vpodlesnyi/Gastroscopy-Controller/DOCUMENTATION/51yf0f-YfbL.jpg

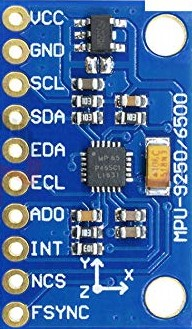
DOCUMENTATION/51yf0f-YfbL.jpg
