vpodlesnyi/Gastroscopy-Controller/DOCUMENTATION/Фотодинамика - Схема соединений.jpg

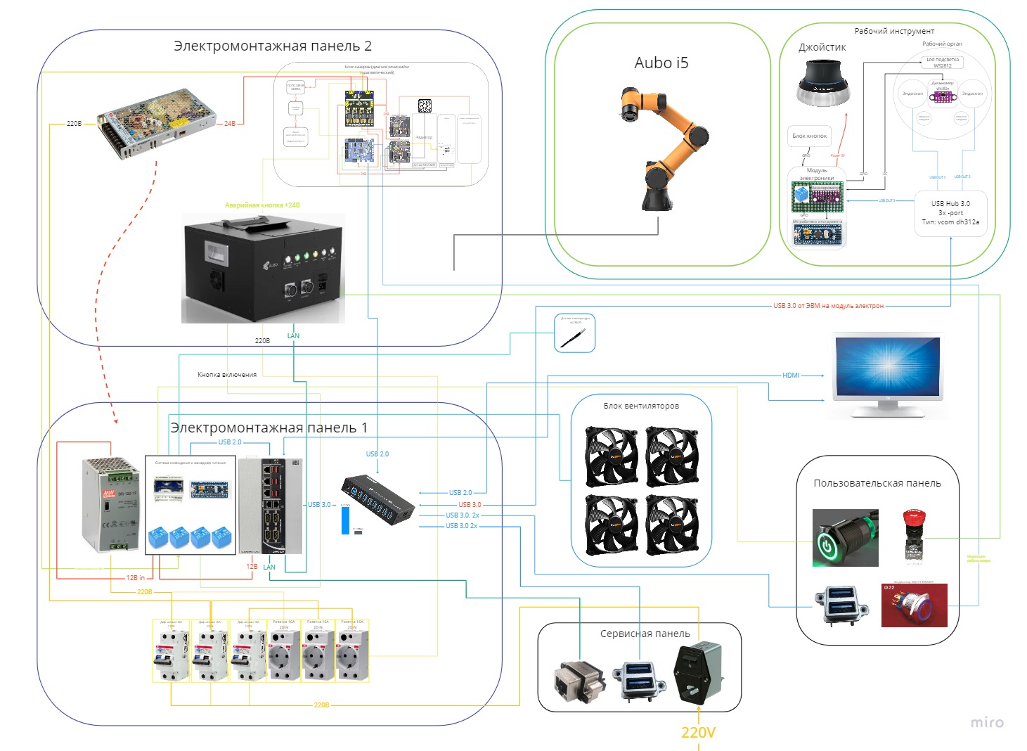
DOCUMENTATION/Фотодинамика - Схема соединений.jpg
