vpodlesnyi/Gastroscopy-Controller/DOCUMENTATION/Рабочий инструмент_ТЗ.docx

Электроника блока рабочего инструмента состоит из двух плат.

1. Плата обработки кнопок и безопасности
  a. Подключение до 6 дискретных кнопок
  b. Подключение акселерометра LIS3DSH (можно прям покупной модуль установить)
  c. Реле 2 штуки
  d. МК stm32f103
  e. Связь через USB
  f. Дополнительный usb type A (мама) для подключения питания джойстика (только питание)
2. Плата трубки
  a. Дальномер vl53l1x (не модуль, сам чип)
  b. Светодиодная подсветка с возможностью регулировки
  c. МК (целесообразность нужно обсудить)

Габариты плат есть в моделях.
