vpodlesnyi/Gastroscopy-Controller/DOCUMENTATION/DS1066-2-FCW.jpg

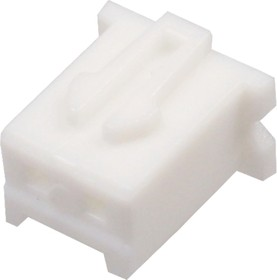
DOCUMENTATION/DS1066-2-FCW.jpg
