vpodlesnyi/Gastroscopy-Controller/DOCUMENTATION/DS1066-6-FCW.jpeg

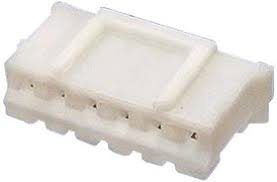
DOCUMENTATION/DS1066-6-FCW.jpeg
