vpodlesnyi/Gastroscopy-Controller/DOCUMENTATION/photo_2022-09-14_12-41-51.jpg

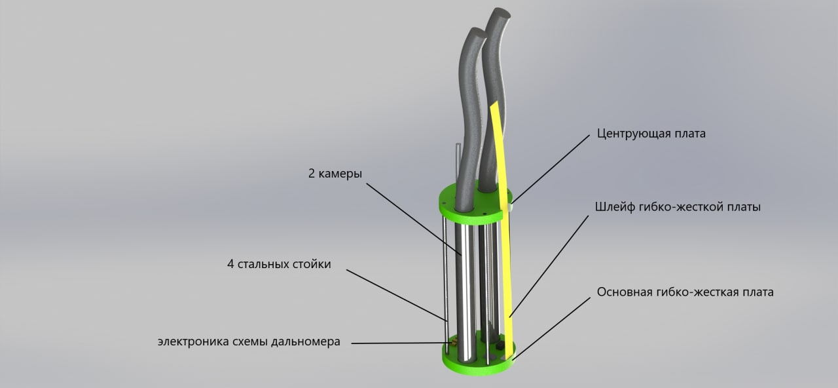
DOCUMENTATION/photo_2022-09-14_12-41-51.jpg
