vpodlesnyi/Gastroscopy-Controller/DOCUMENTATION/photo_2022-09-14_12-46-19.jpg

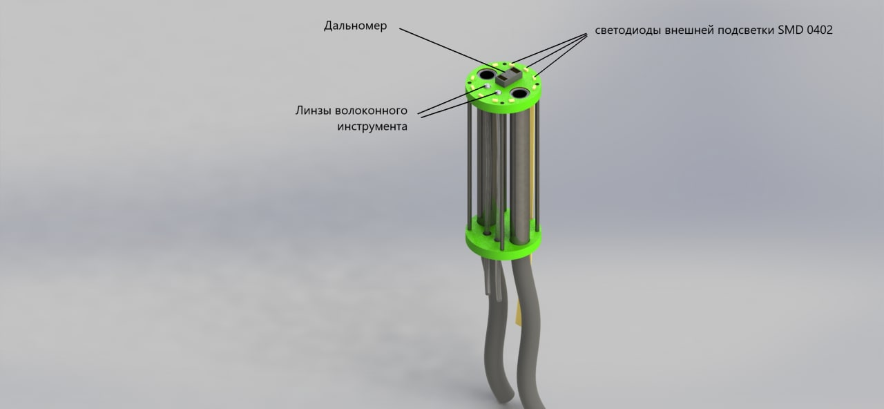
DOCUMENTATION/photo_2022-09-14_12-46-19.jpg
