vpodlesnyi/Gastroscopy-Controller/DOCUMENTATION/photo_2022-10-16_23-45-35.jpg

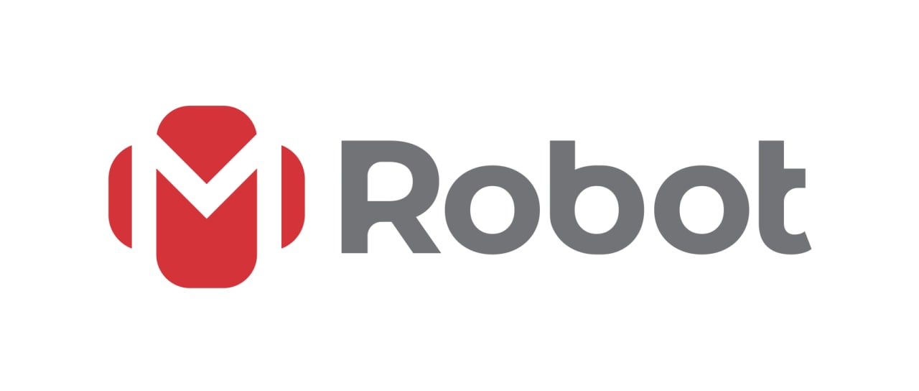
DOCUMENTATION/photo_2022-10-16_23-45-35.jpg
