vpodlesnyi/Gastroscopy-Controller/DOCUMENTATION/photo_2022-10-17_15-40-24-removebg-preview.png

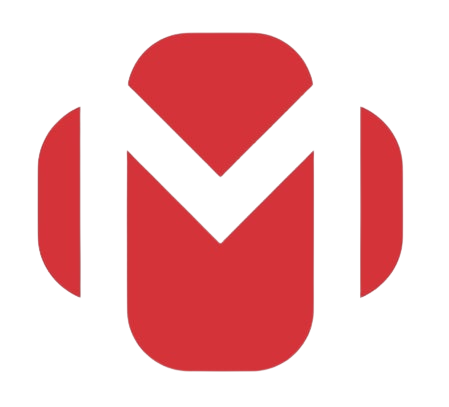
DOCUMENTATION/photo_2022-10-17_15-40-24-removebg-preview.png
