vpodlesnyi/Gastroscopy-Controller/DOCUMENTATION/Безымянный.png

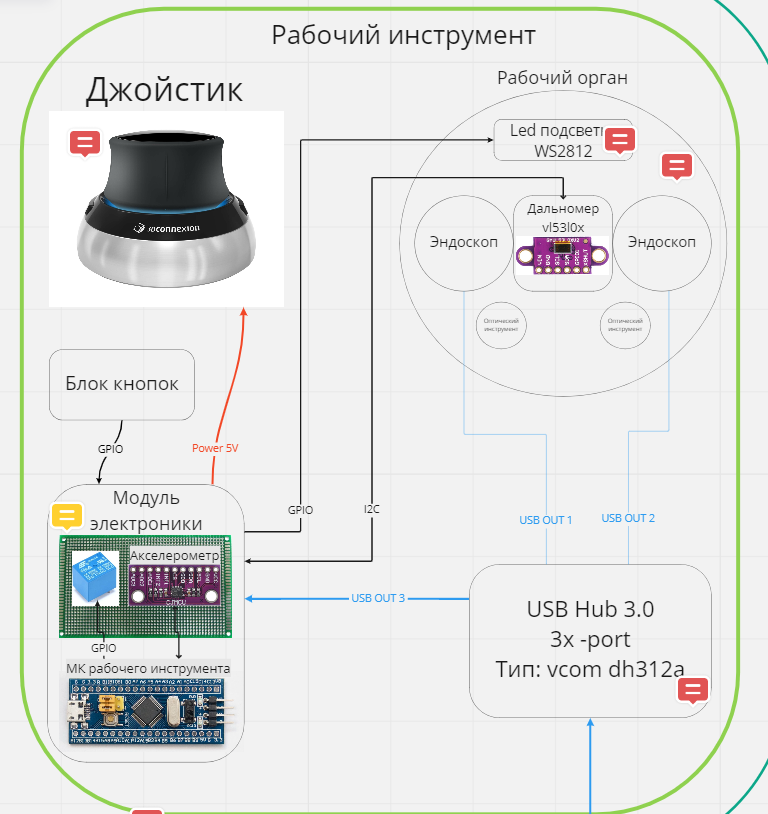
DOCUMENTATION/Безымянный.png
