vpodlesnyi/Gastroscopy-Controller/OUTPUT/BOM/Gastroscopy-Controller_BOM_Rev_0.1.0_No Variations.xlsx

Sheet: Part List Report
Component list
Source Data From: |  | Gastroscopy-Controller.BomDoc
Project: |  | Gastroscopy-Controller.PrjPcb
Variant: |  | None
BOM Revision |  | 0.1.0
Report Date: |  | 11.11.2022 | 12:59
Print Date: |  | 2022-11-16 | 14:18:09
# | Designator | Description | Manufacturer 1 | Manufacturer Part Number 1 | Quantity
1 | C1, C2, C3, C4, C5, C6, C7, C8, C9, C10, C11, C12, C15, C17, C18, C19, C20, C24, C25, C27, C28 | CAP CER 0.1UF 50V X7R 0603 | Samsung | CL10B104KB8NNNL | 21
2 | C13, C14, C16, C23, C26 | CAP CER 10UF 16V X7R 0805 | Samsung | CL21B106KOQNNNE | 5
3 | C21, C22 | CAP CER 30PF 50V NPO 0603 | Yageo | CC0603JRNPO9BN300 | 2
4 | D1, D2, D3, D4, D5, D6, D14, D15 | TVS DIODE 5VWM 9.2VC SMB | Good-Ark | SMBJ5.0CA | 8
5 | D7, D10, D12 | DIODE SCHOTTKY 40V 1A SOD323 | Nexperia | PMEG4010BEA115 | 3
6 | D8 | LED BLUE CLEAR CHIP SMD | Vishay Lite-On | LTST-C193TBKT-5A | 1
7 | D9 | LED GREEN CLEAR SMD | Vishay Lite-On | LTST-C191KGKT | 1
8 | D11, D13 | TVS DIODE 24VWM 38.9VC SMB | Taiwan Semiconductor | SMBJ24A | 2
9 | DA1, DA2, DA3, DA4, DA5, DA6 | OPTOISOLATOR 5KV TRANSISTOR 4SMD | Broadcom Avago | HCPL-817-50CE | 6
10 | DA7 | IC REG LINEAR 3.3V 500MA SOT23-5 | Texas Instruments | TLV75533PDBVR | 1
11 | HW1, HW4, HW7, HW10, HW13, HW16 | CONN SOCKET 2POS 2MM | Connfly electronic (Zhenqin) | DS1066-2-FCW | 6
12 | HW2, HW3, HW5, HW6, HW8, HW9, HW11, HW12, HW14, HW15, HW17, HW18, HW19, HW20, HW22, HW23, HW25, HW26, HW27, HW28, HW29, HW30, HW31, HW32 | СONNECTOR DS1066 | Connfly electronic (Zhenqin) | T-DS1066-SC600-N-019 | 24
13 | HW21, HW24 | CONN SOCKET 6POS 2MM | Connfly electronic (Zhenqin) | DS1066-6-FCW | 2
14 | HW33 | CLOSED TOP JUMPER SOCKET | Harwin | M7686-05 | 1
15 | J1, J2 | TERM BLK 3P TOP ENTRY 5MM SMD | Degson | DG128-5.0-03P-14-00AH | 2
16 | J3 | CONN RCPT USB2.0 TYPEA 4POS R/A | TE Connectivity | 292303-1 | 1
17 | J4 | CONN TYPE B SKT HORIZONTAL TH | Ningbo Connfly Electric | DS1099-WN0 | 1
18 | JP1, JP2, JP3, JP4, JP5, JP6 | CONN HEADER 2POS 2MM | Connfly electronic (Zhenqin) | DS1066-2MVW6X | 6
19 | JP7, JP8 | CONN PLUG 6POS 2MM | Connfly electronic (Zhenqin) | DS1066-6MVW6X | 2
20 | JP9 | CONN HEADER VERT 6POS 2.54MM | Wurth Electronics | 61300611121 | 1
21 | JP10 | CONN HEADER VERT 2POS 2.54MM | Wurth Electronics | 61300211121 | 1
22 | K1, K2 | RELAY GEN PURPOSE SPDT 10A 5V | TE Connectivity Schrack | RT174005 | 2
23 | L1 | FIXED IND 4.7UH 650MA 270MOHM SM | TDK | NLC453232T-4R7K-PF | 1
24 | Q1, Q2 | MOSFET N-CH 30V 3.3A/3.6A SOT23 | Vishay Siliconix | SI2304DDS-T1-GE3 | 2
25 | R1, R4, R7, R10, R13, R16, R25 | RES 360 OHM 1% 1/10W 0603 | Yageo | RC0603FR-07360RL | 7
26 | R2, R5, R8, R11, R14, R17 | RES 1K OHM 1% 1/10W 0603 | Yageo | RC0603FR-071KL | 6
27 | R3, R6, R9, R12, R15, R18, R24, R27, R29 | RES 100 OHM 1% 1/10W 0603 | Yageo | RC0603FR-07100RL | 9
28 | R19, R22, R23, R26, R28, R30, R34 | RES 10K OHM 1% 1/10W 0603 | Yageo | RC0603FR-0710KL | 7
29 | R20 | RES 62K OHM 1% 1/10W 0603 | Yageo | RC0603FR-0762KL | 1
30 | R21 | RES 10 OHM 1% 1/10W 0603 | Yageo | RC0603FR-0710RL | 1
31 | R31, R32 | RES 24 OHM 1% 1/10W 0603 | Yageo | RC0603FR-0724RL | 2
32 | R33 | RES 1.5K OHM 1% 1/10W 0603 | Yageo | RC0603FR-071K5L | 1
33 | U1 | IC LED DRVR RGLTR PWM 20MA 8QFN | STMicroelectronics | STLD40DPUR | 1
34 | U2 | TVS DIODE 5VWM 17.5VC SOT23-6 | Sangdest Microelectronics | SRV05-4ATR | 1
35 | U3 | IC MCU 32BIT 128KB FLASH 48LQFP | STMicroelectronics | STM32F103CBT6 | 1
36 | U4 | TVS DIODE 5.25VWM 17VC SOT23-6 | STMicroelectronics | USBLC6-2SC6 | 1
37 | U5 | ACCEL 2-16G I2C/SPI 16LGA | STMicroelectronics | LIS3DHTR | 1
38 | Y1 | CRYSTAL 8.0000MHZ 18PF TH | CTS | ATS080B-E | 1
Total |  |  |  |  | 142

Sheet: Project Information
Project Full Path | C:\Users\Naval\OneDrive\Документы\Gastroscopy-Controller\Gastroscopy-Controller.PrjPcb
Project Filename | Gastroscopy-Controller.PrjPcb
Variant Name | None
Data-Source Filename | Gastroscopy-Controller.BomDoc
Data-Source Full Path | C:\Users\Naval\OneDrive\Документы\Gastroscopy-Controller\BOM\Gastroscopy-Controller.BomDoc
Title | BOM for BOM Document [Gastroscopy-Controller.BomDoc]
Total Quantity | 142
Report Time | 12:59
Report Date | 11.11.2022
Report Date & Tine | 11.11.2022 12:59
Output Name | BOM
Output Type | BomReport
Output Generator Name | BOM
Output Generator Description | Bill of Materials
