vpodlesnyi/Gastroscopy-Controller/DOCUMENTATION/плата_15_1.DXF

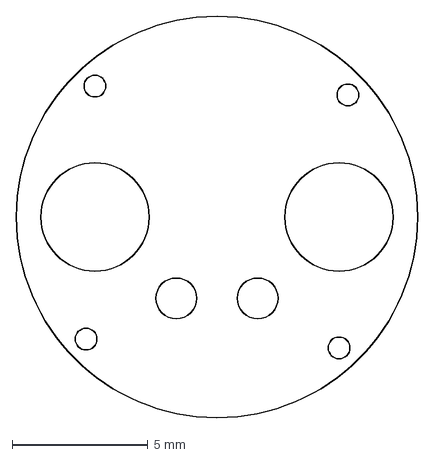
[picture p10: CAD file, 2022-11-09]
DOCUMENTATION/плата_15_1.DXF
14.8 x 14.8 mm
