vpodlesnyi/Gastroscopy-Controller/DOCUMENTATION/плата_130х70.DXF

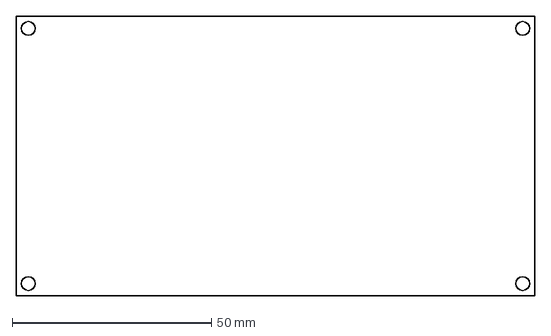
[picture p11: CAD file, 2022-11-09]
DOCUMENTATION/плата_130х70.DXF
130.0 x 70.0 mm
