vpodlesnyi/Gastroscopy-Controller/DOCUMENTATION/плата_15_2.DXF

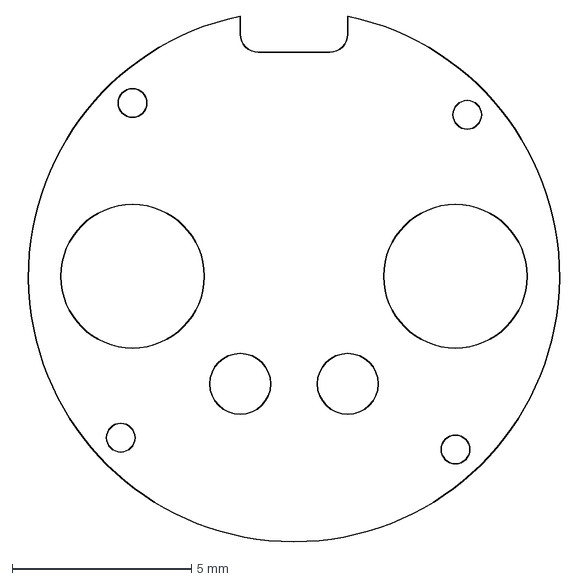
[picture p12: CAD file, 2022-11-09]
DOCUMENTATION/плата_15_2.DXF
15.5 x 14.6 mm
