vpodlesnyi/Gastroscopy-Controller/OUTPUT/SCH/Gastroscopy-Controller_SCH_Rev_0.1.0_[No Variations].PDF

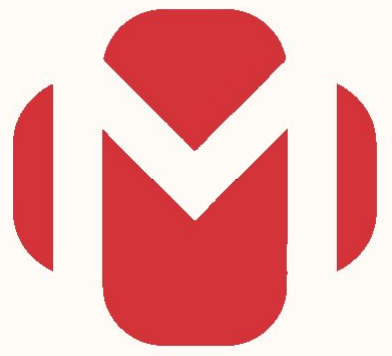
[picture p13: figure]

16.11.2022

# GastroscopyController

### Company: MRobot, LCC

Jira Key: | GSTRCNTRL
Project: | Gastroscopy Controller

# Gastroscopy Controller

Overview
Gastroscopy-Controller_Overview.SchDoc

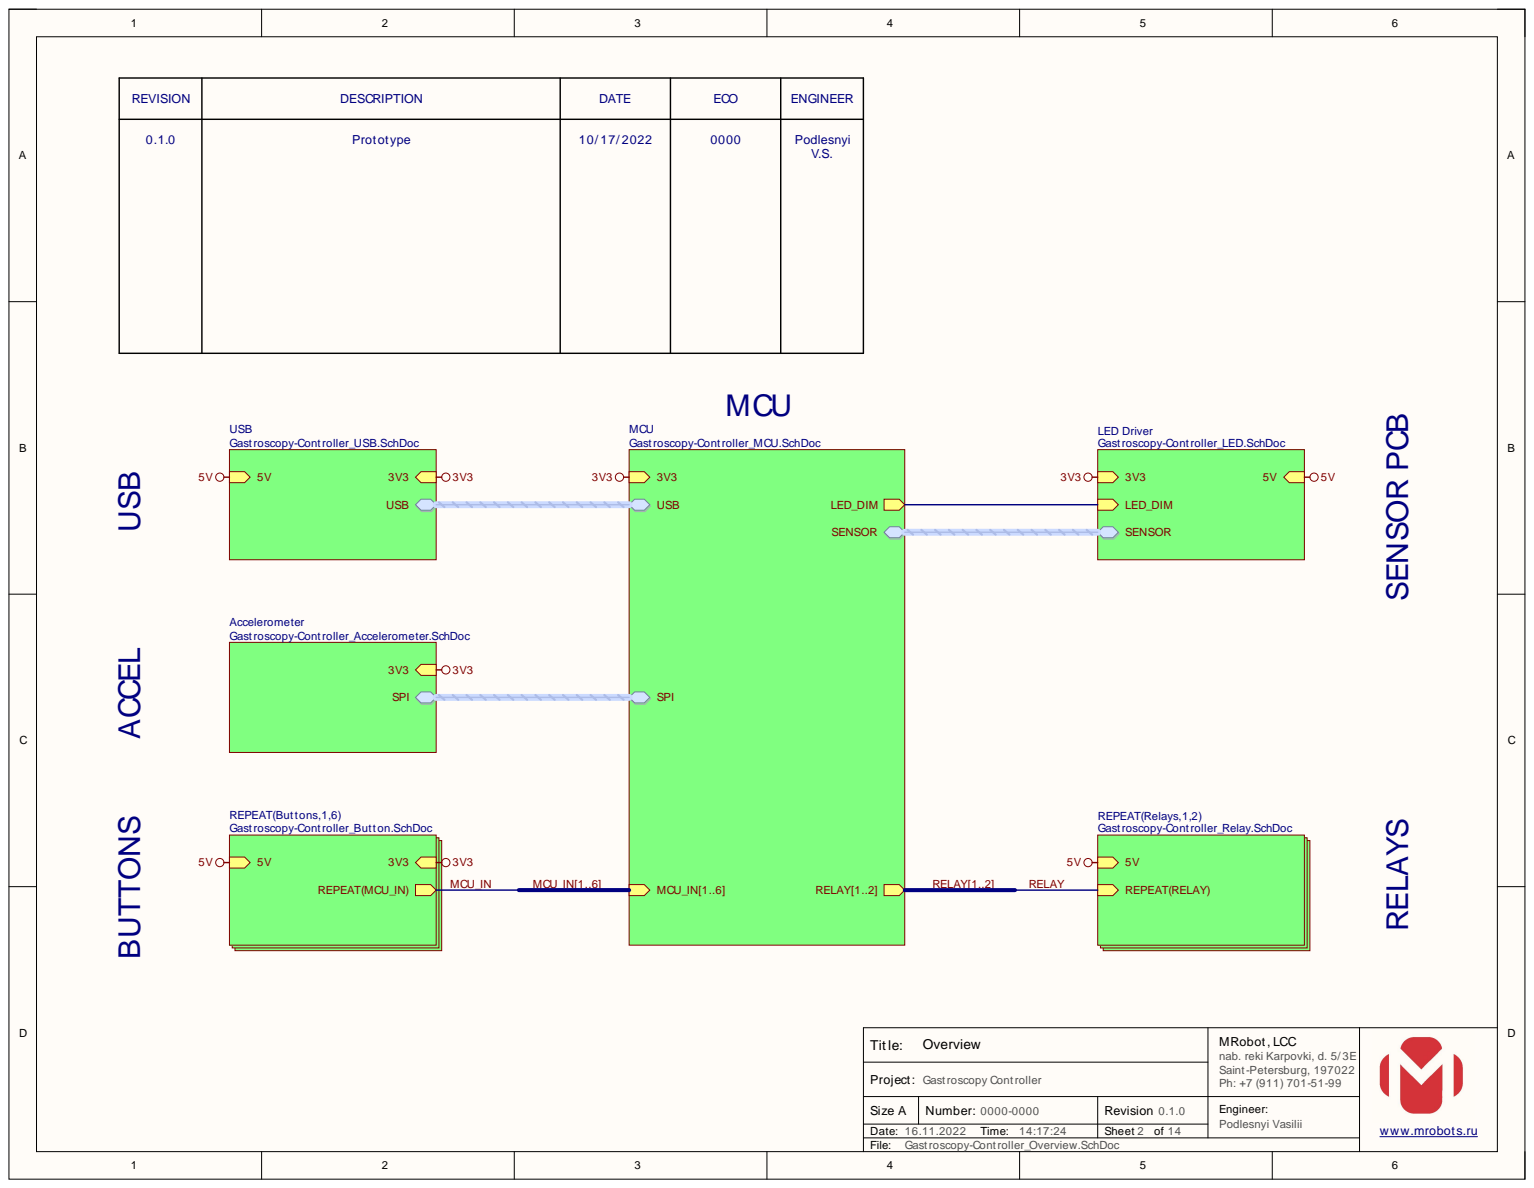
[picture p14: page 2]

REVISION | DESCRIPTION | DATE | ECO | ENGINEER

0.1.0 | Protot ype | 10/ 17/ 2022 | 0000 | Podlesnyi V.S.

Size A | Number: | Revision 0.1.0 | Engineer: Podlesnyi Vasilii

Date: 16.11.2022 Time: 14:17:24 | | Sheet of

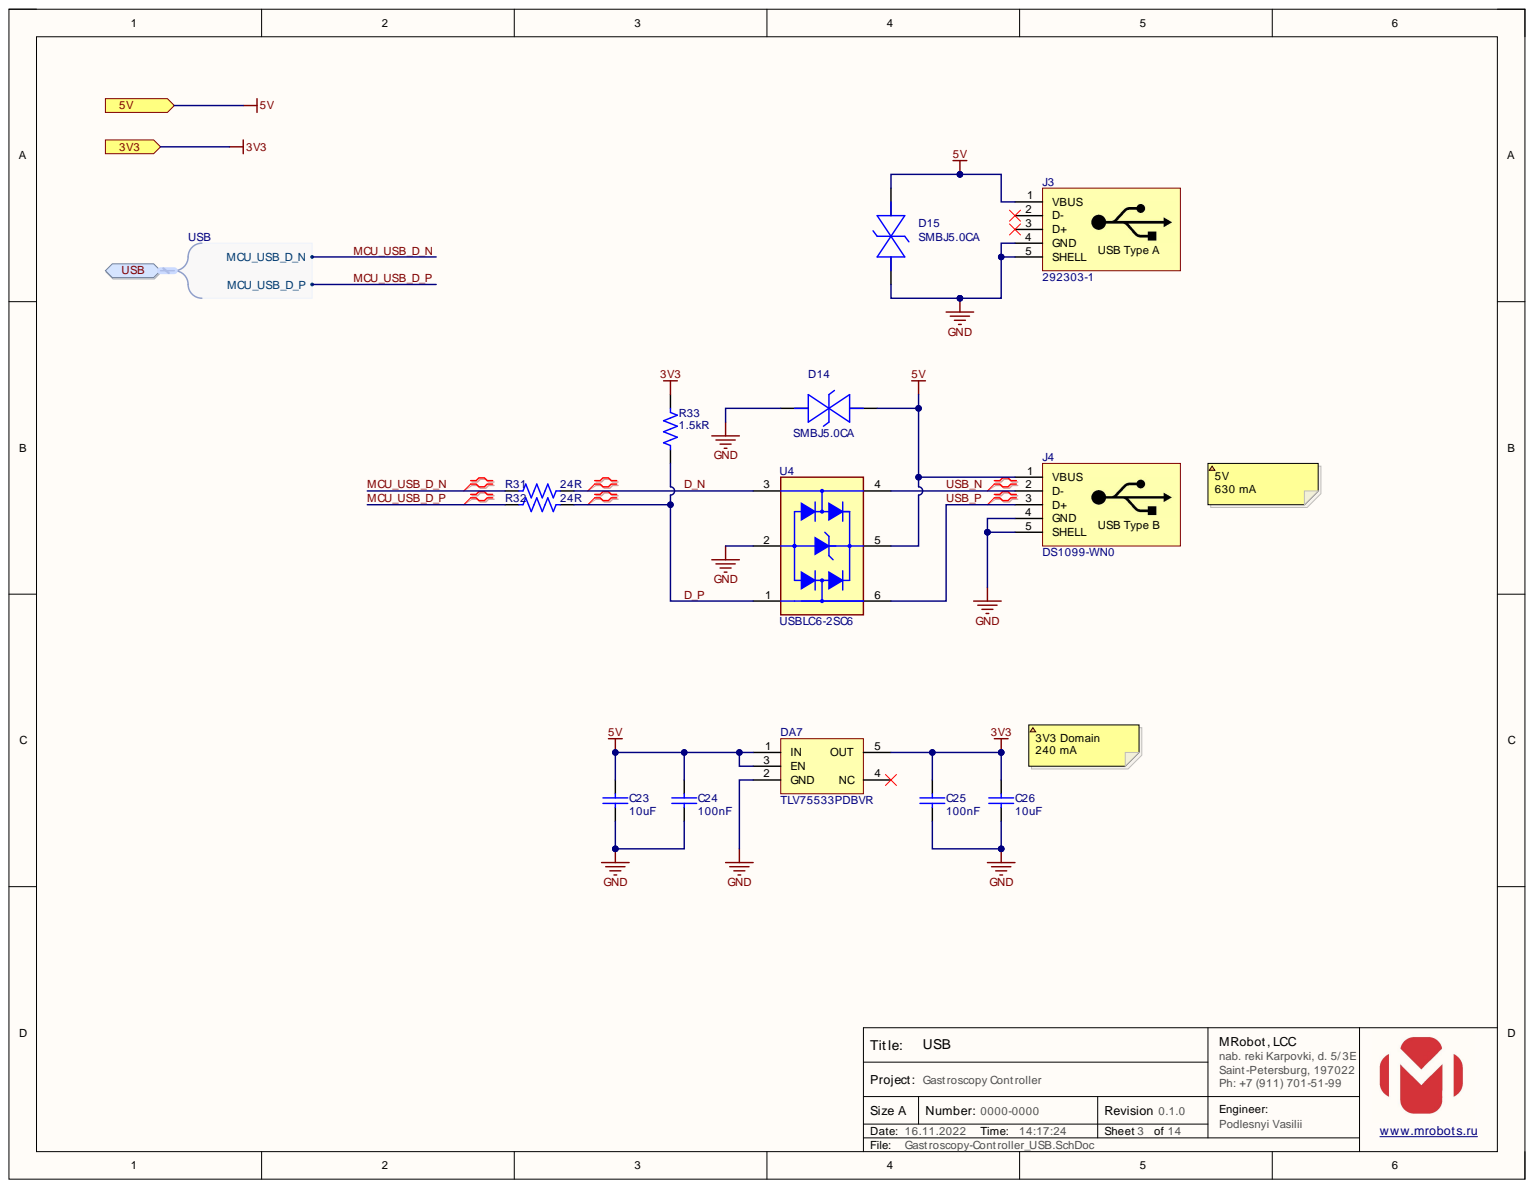
[picture p15: page 3]

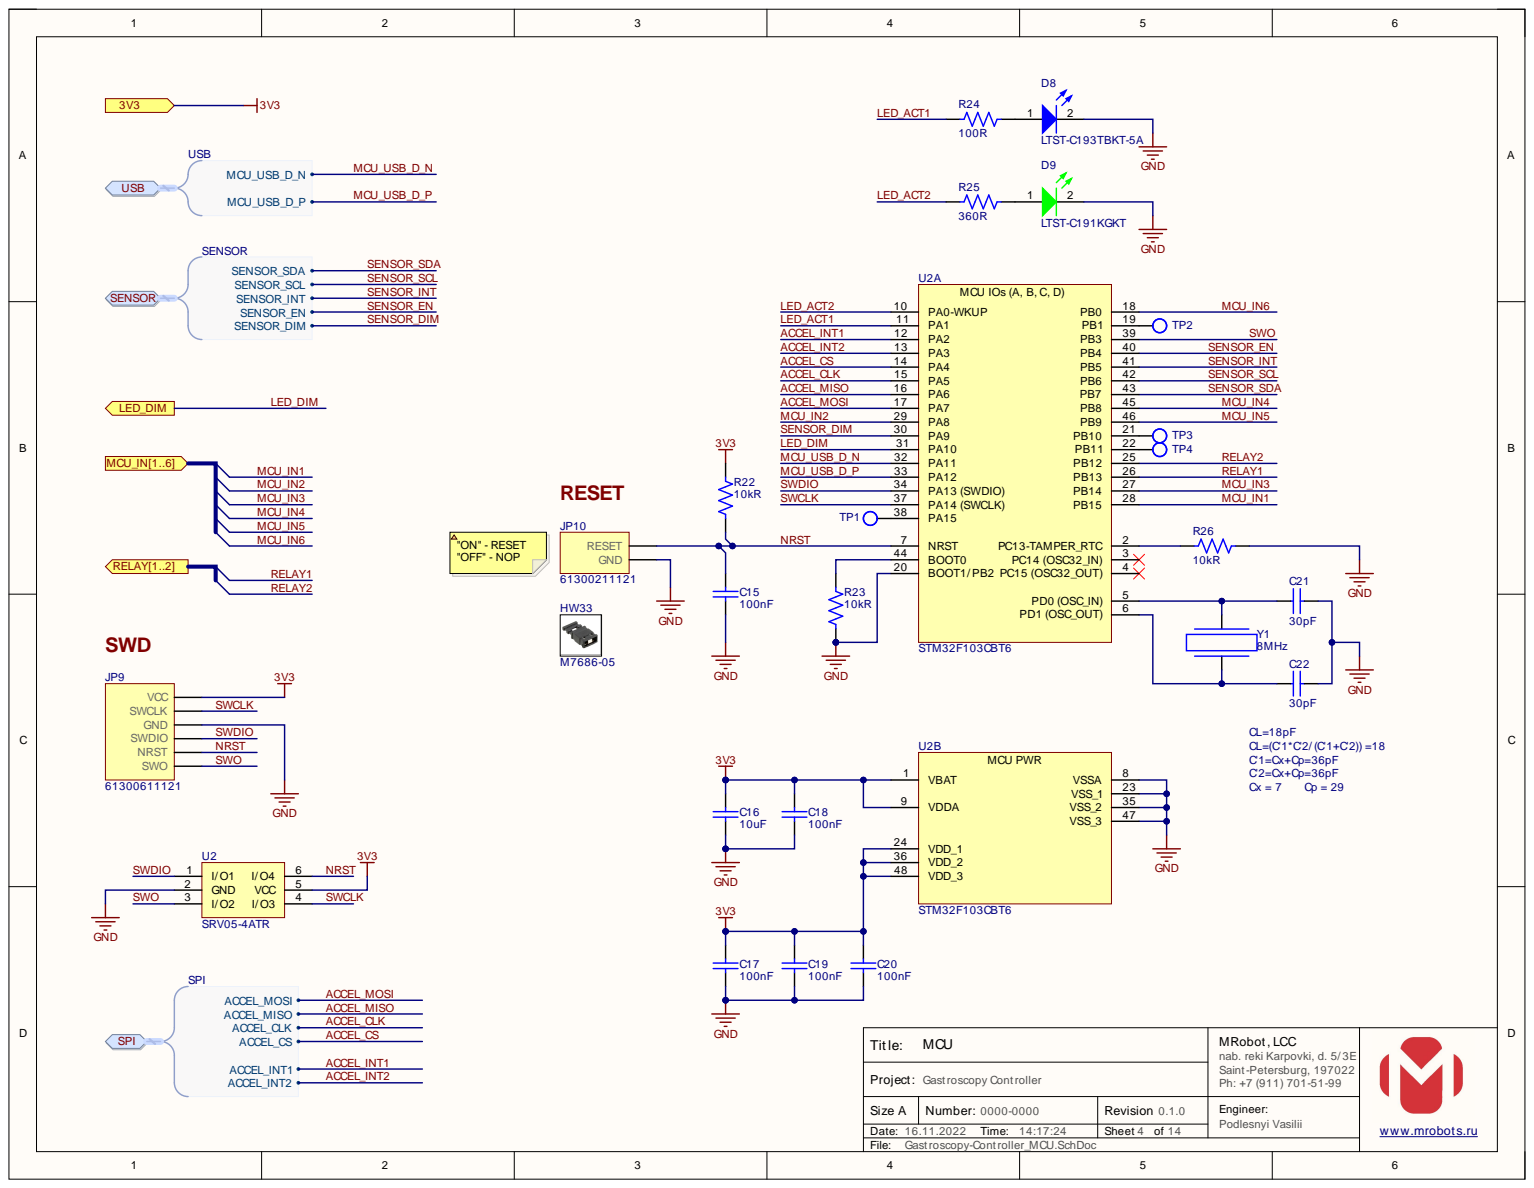
[picture p16: page 4]

BOOT0 44
BOOT1/ PB2 20

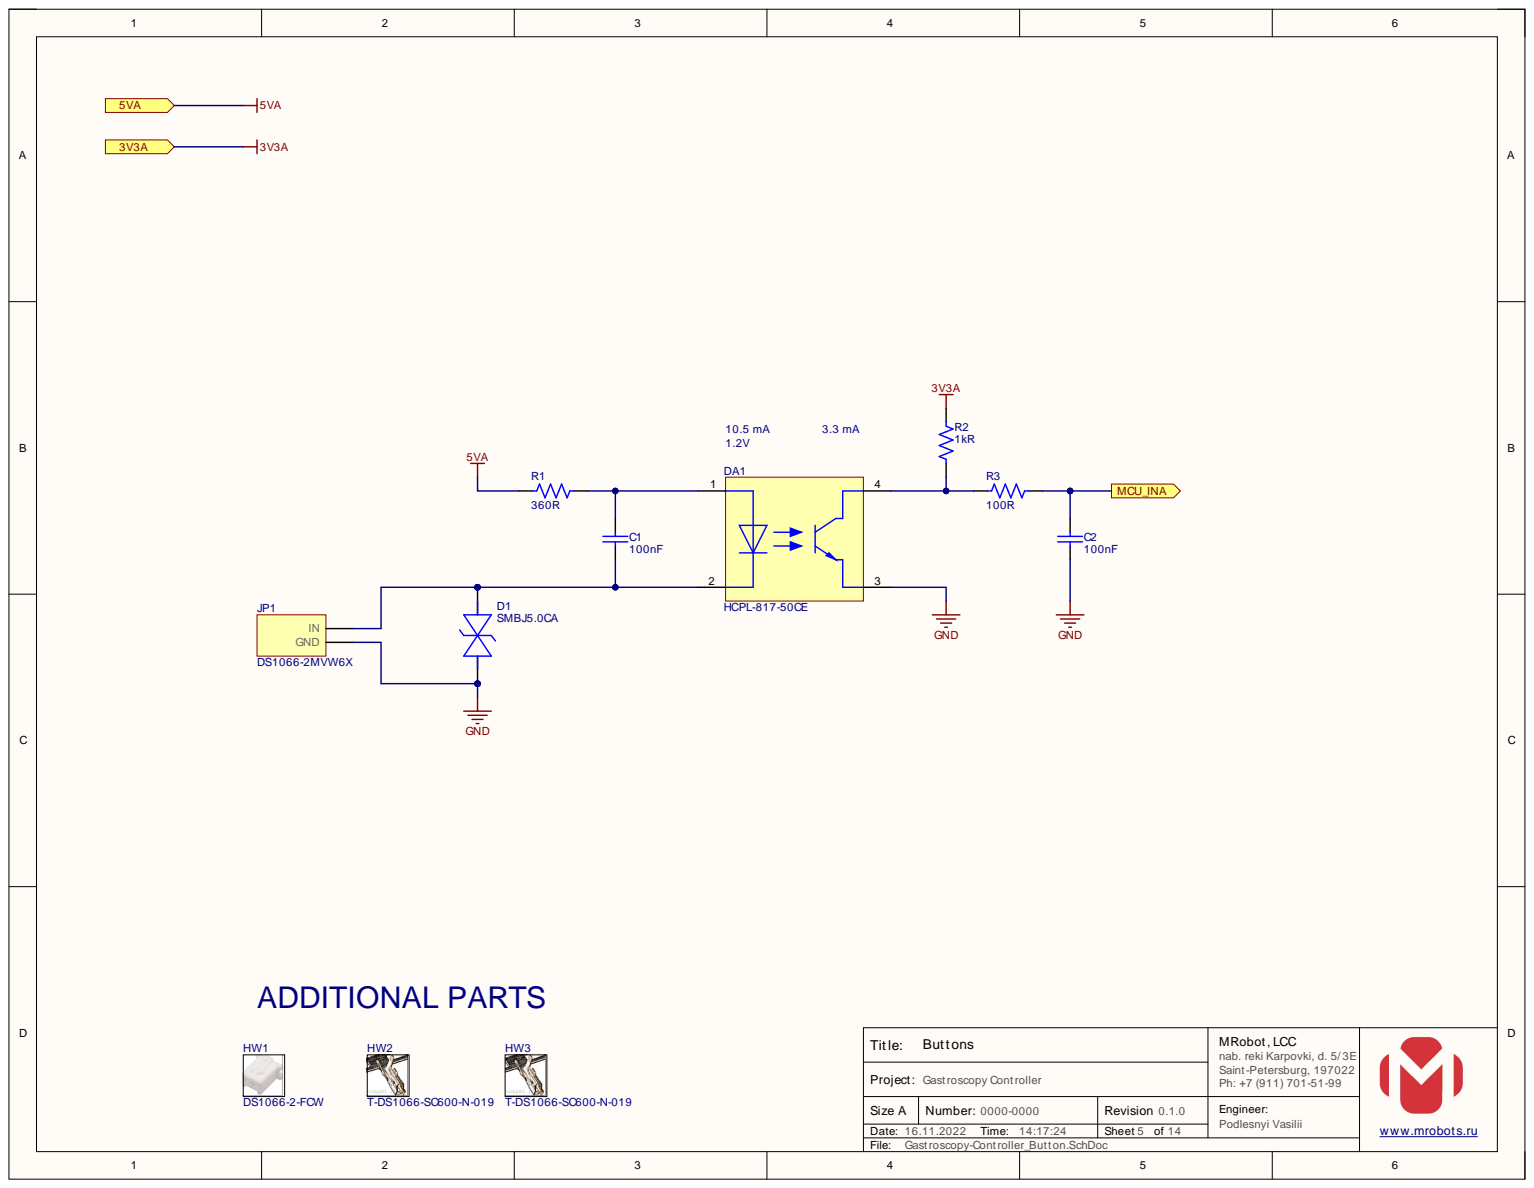
[picture p17: page 5]

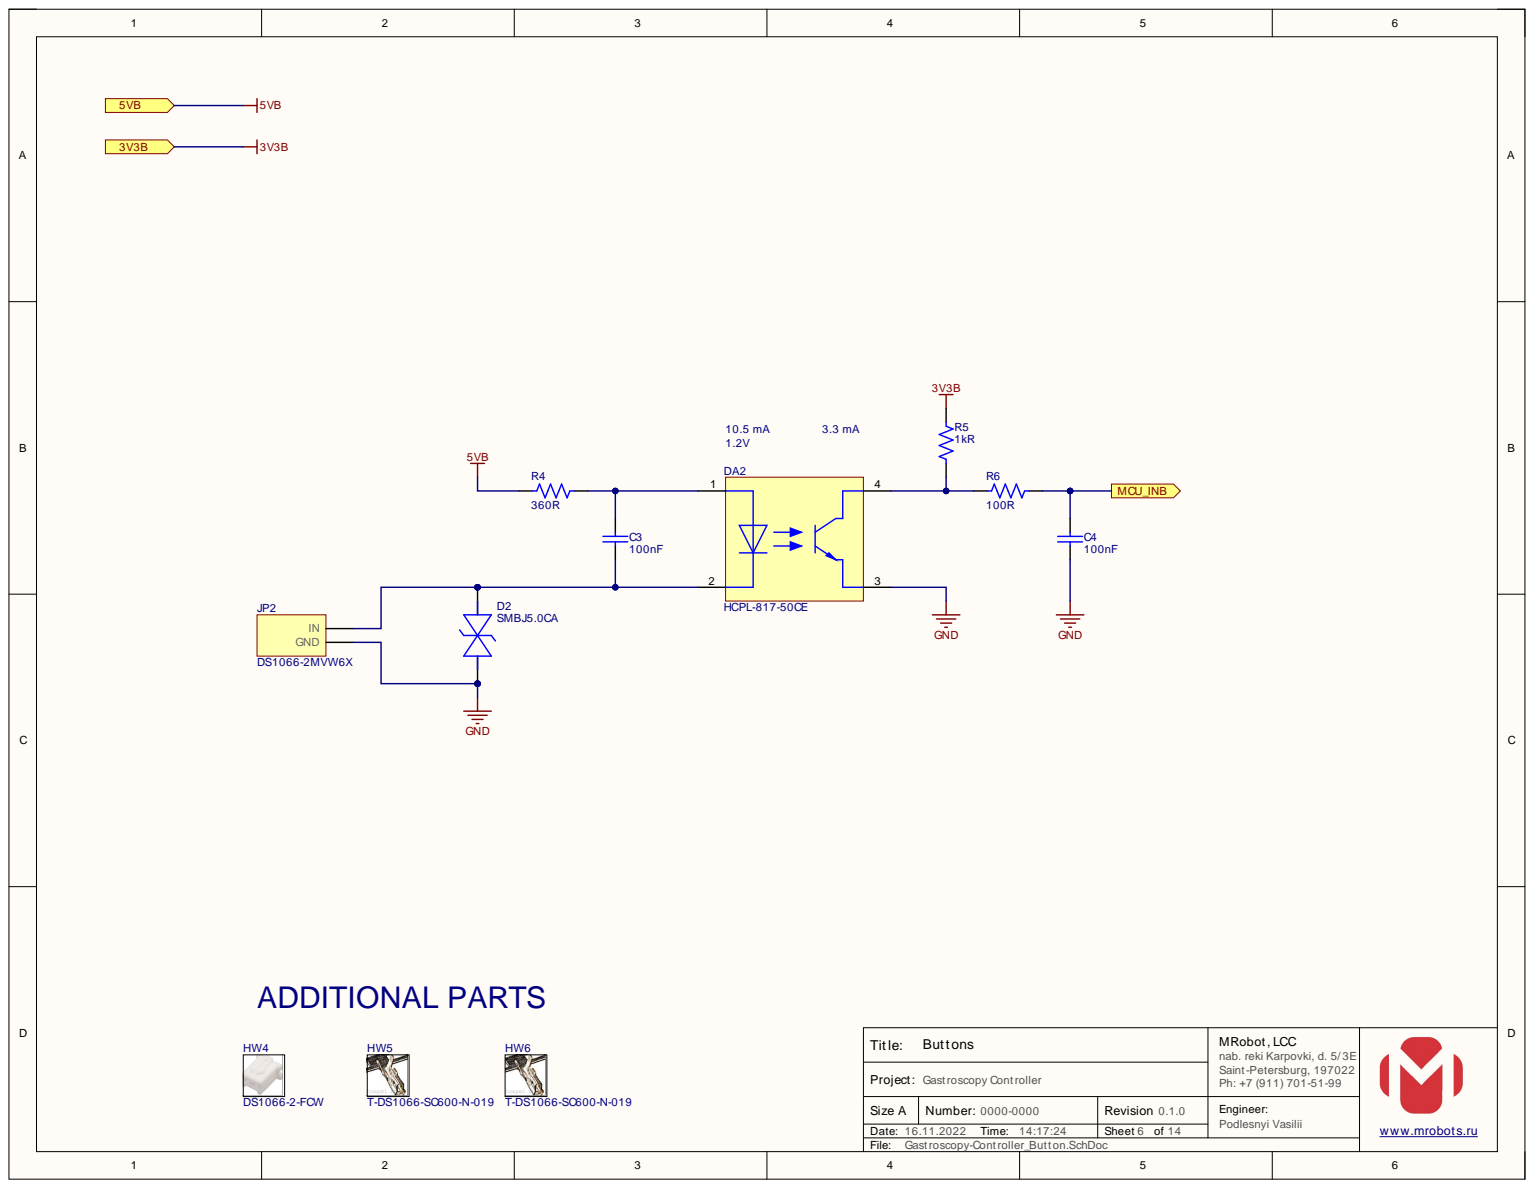
[picture p18: page 6]

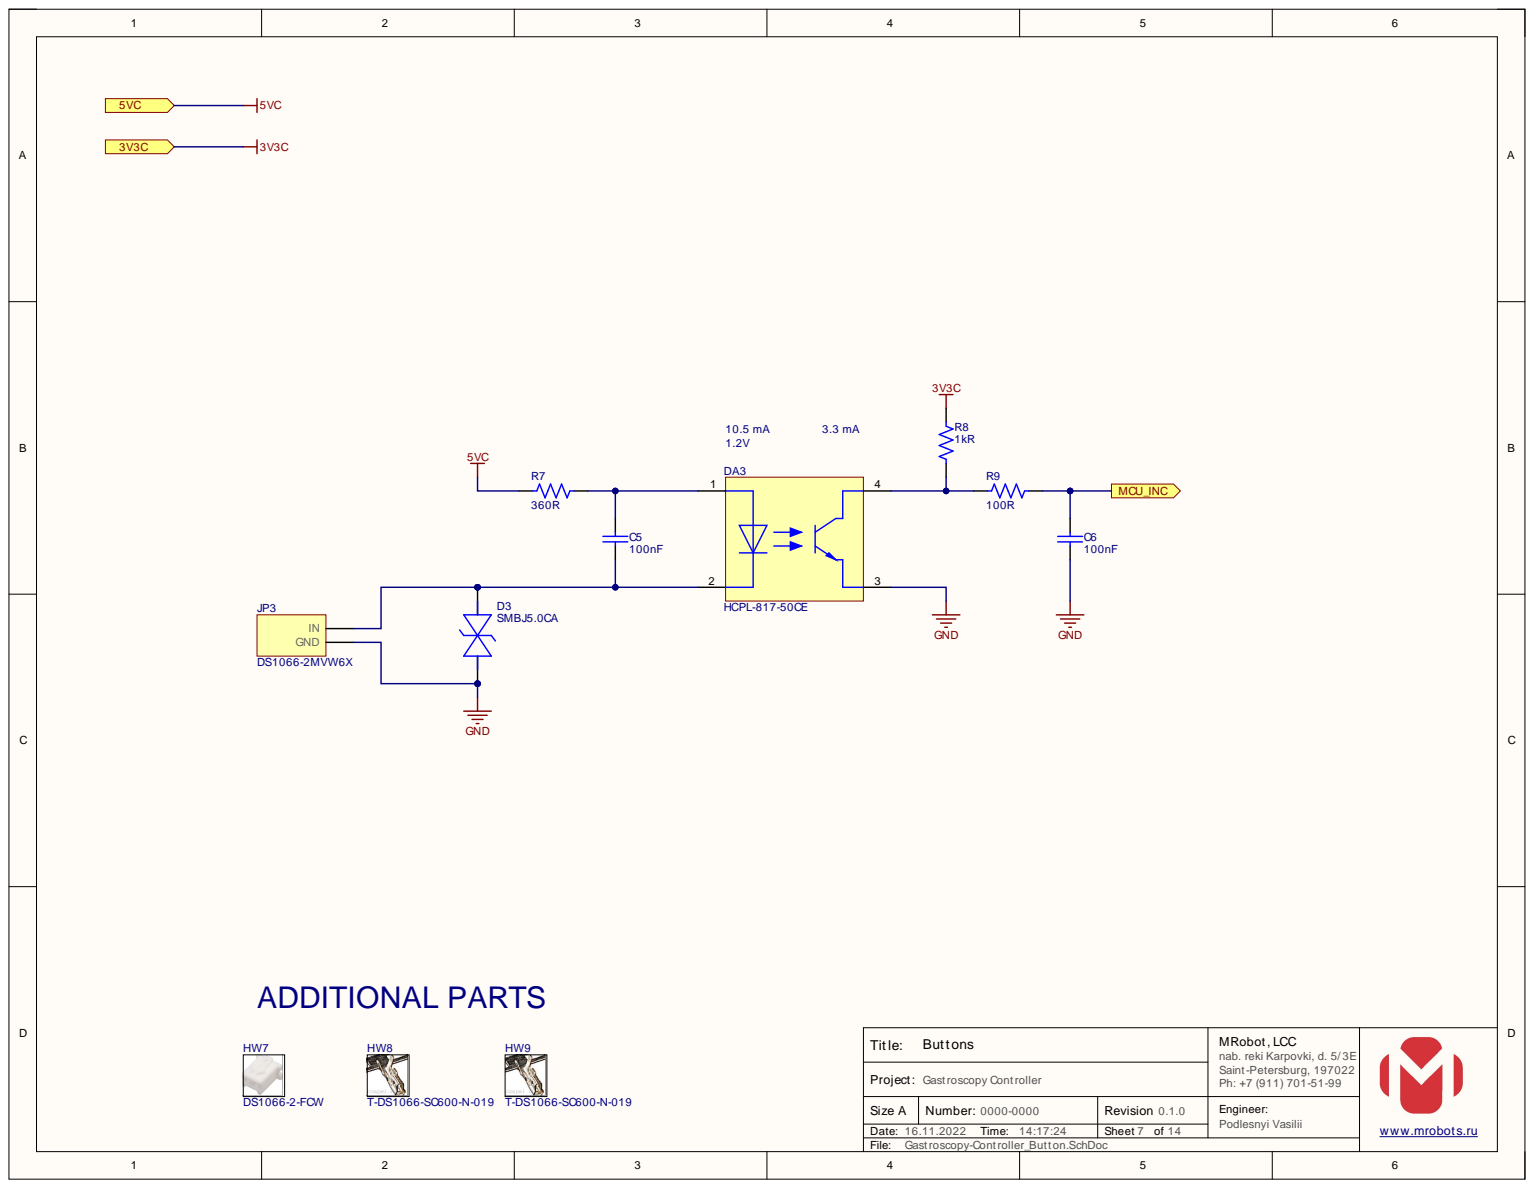
[picture p19: page 7]

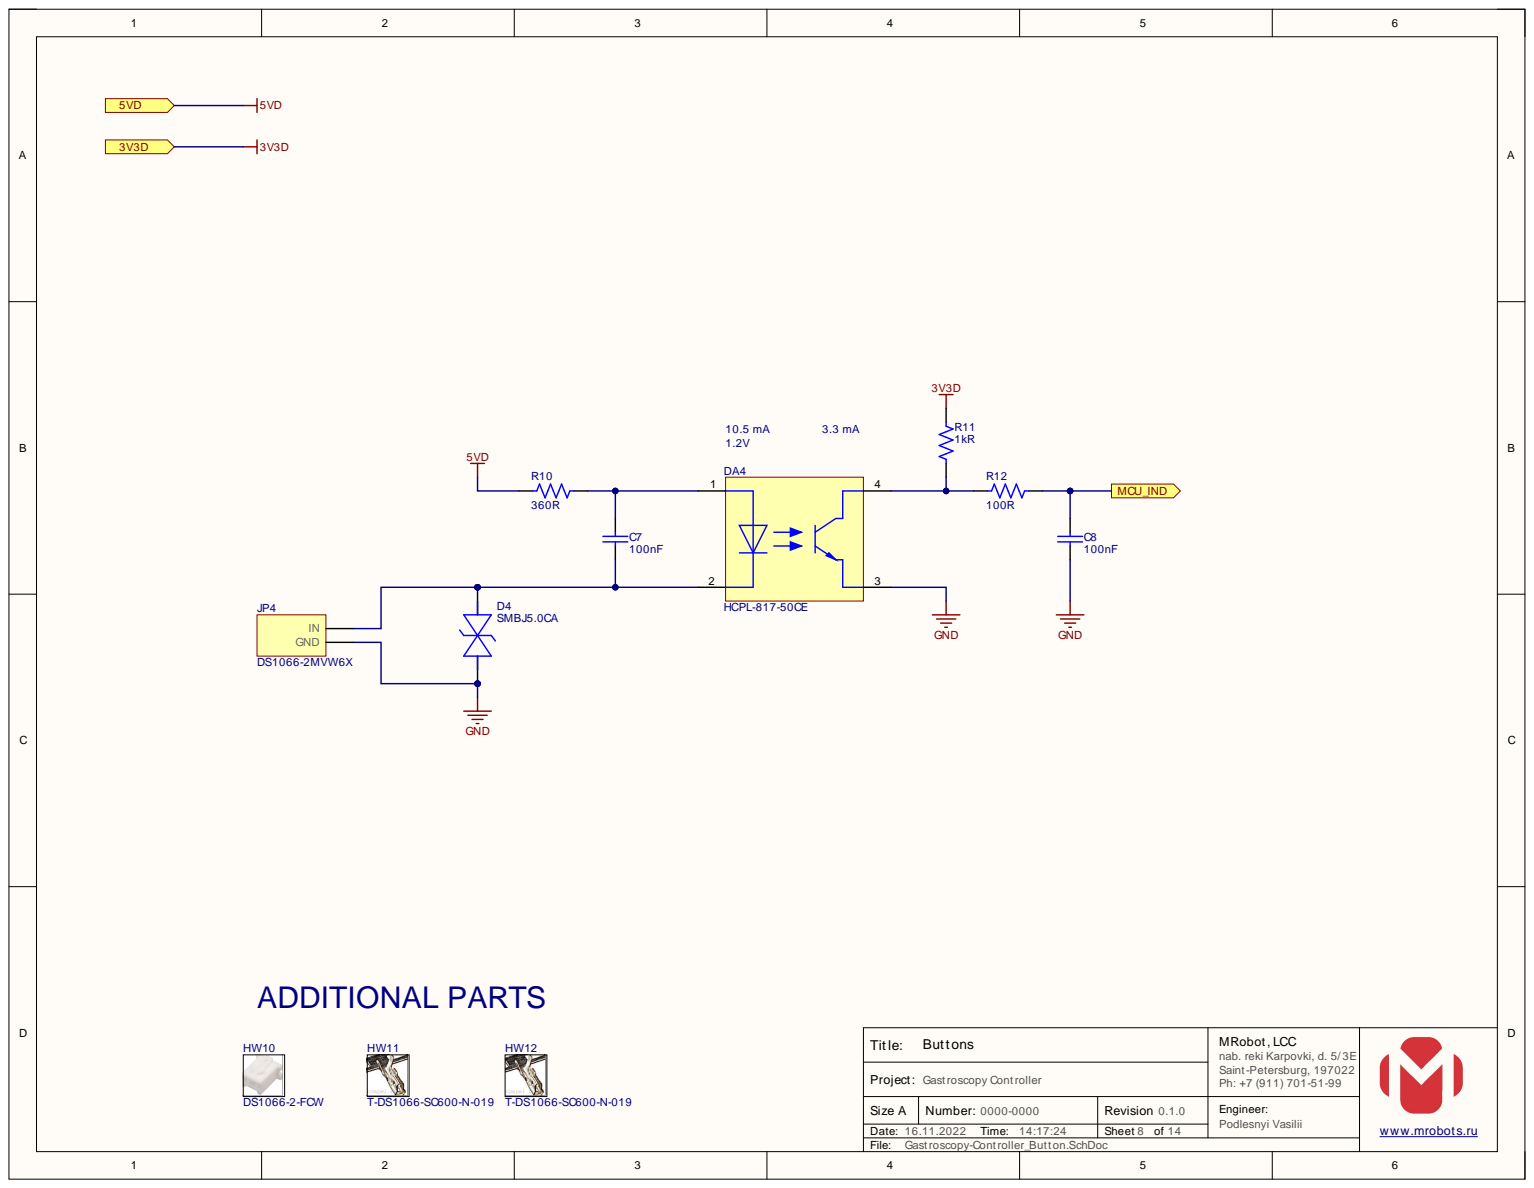
[picture p20: page 8]

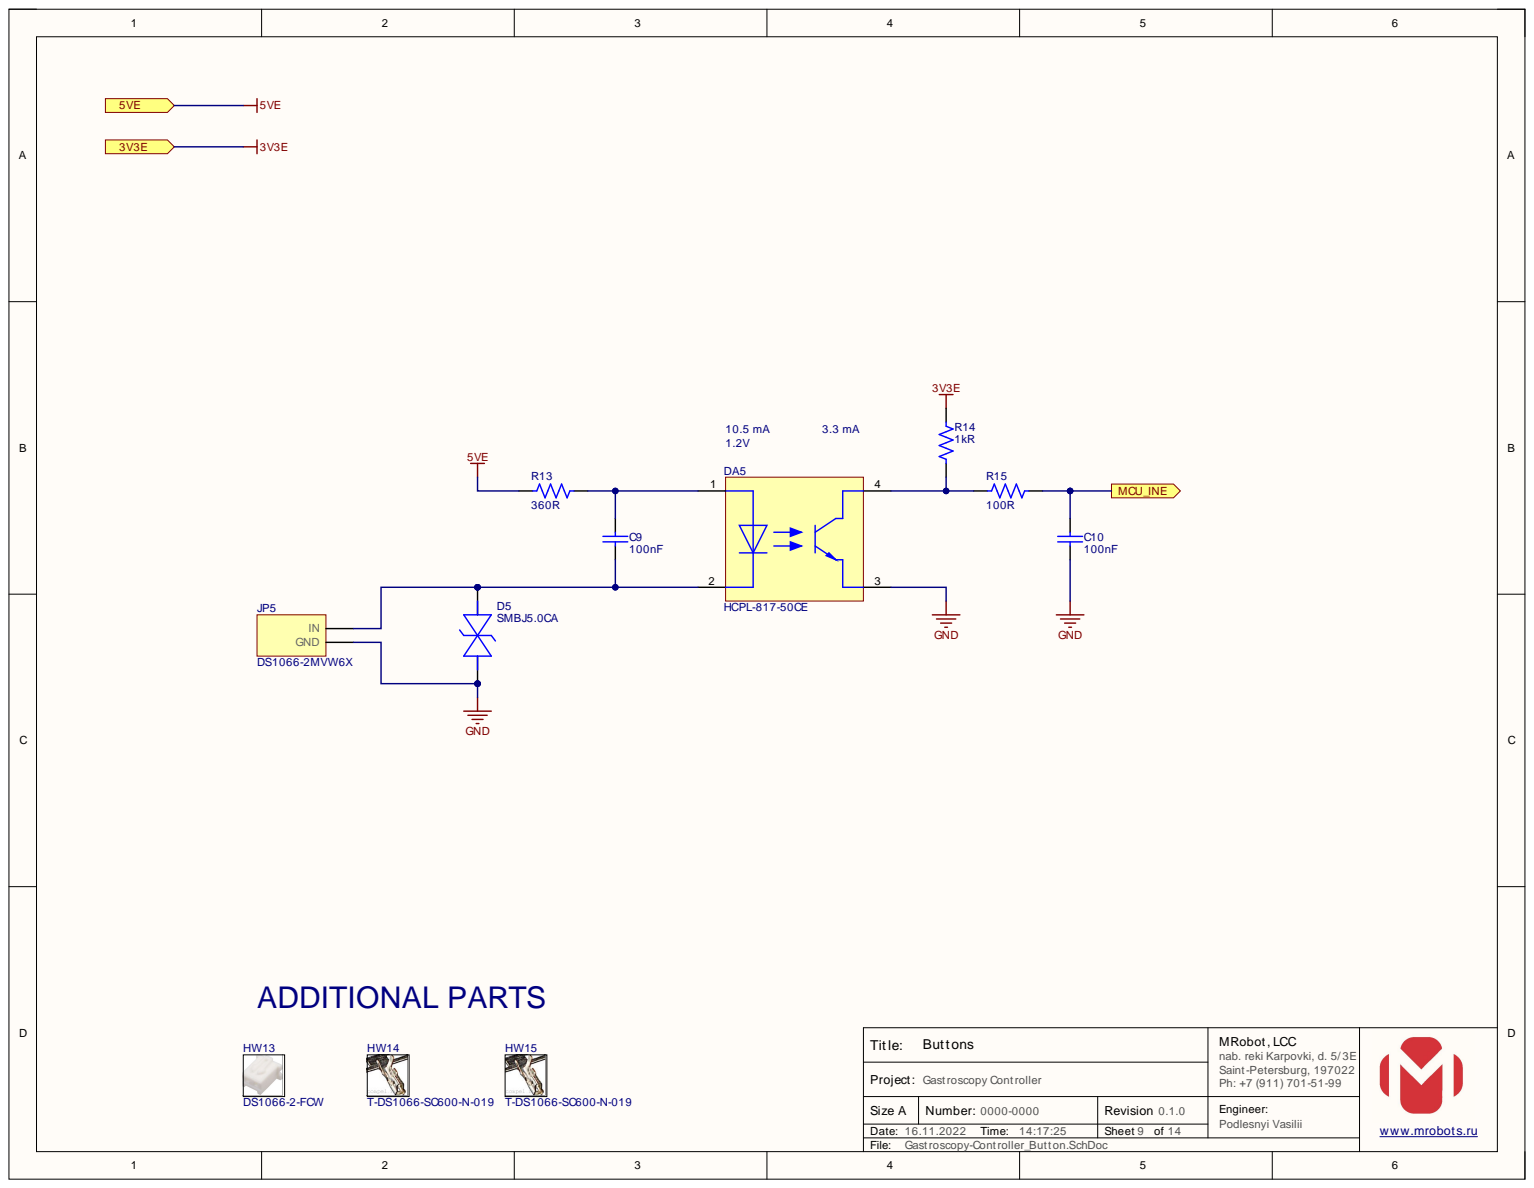
[picture p21: page 9]

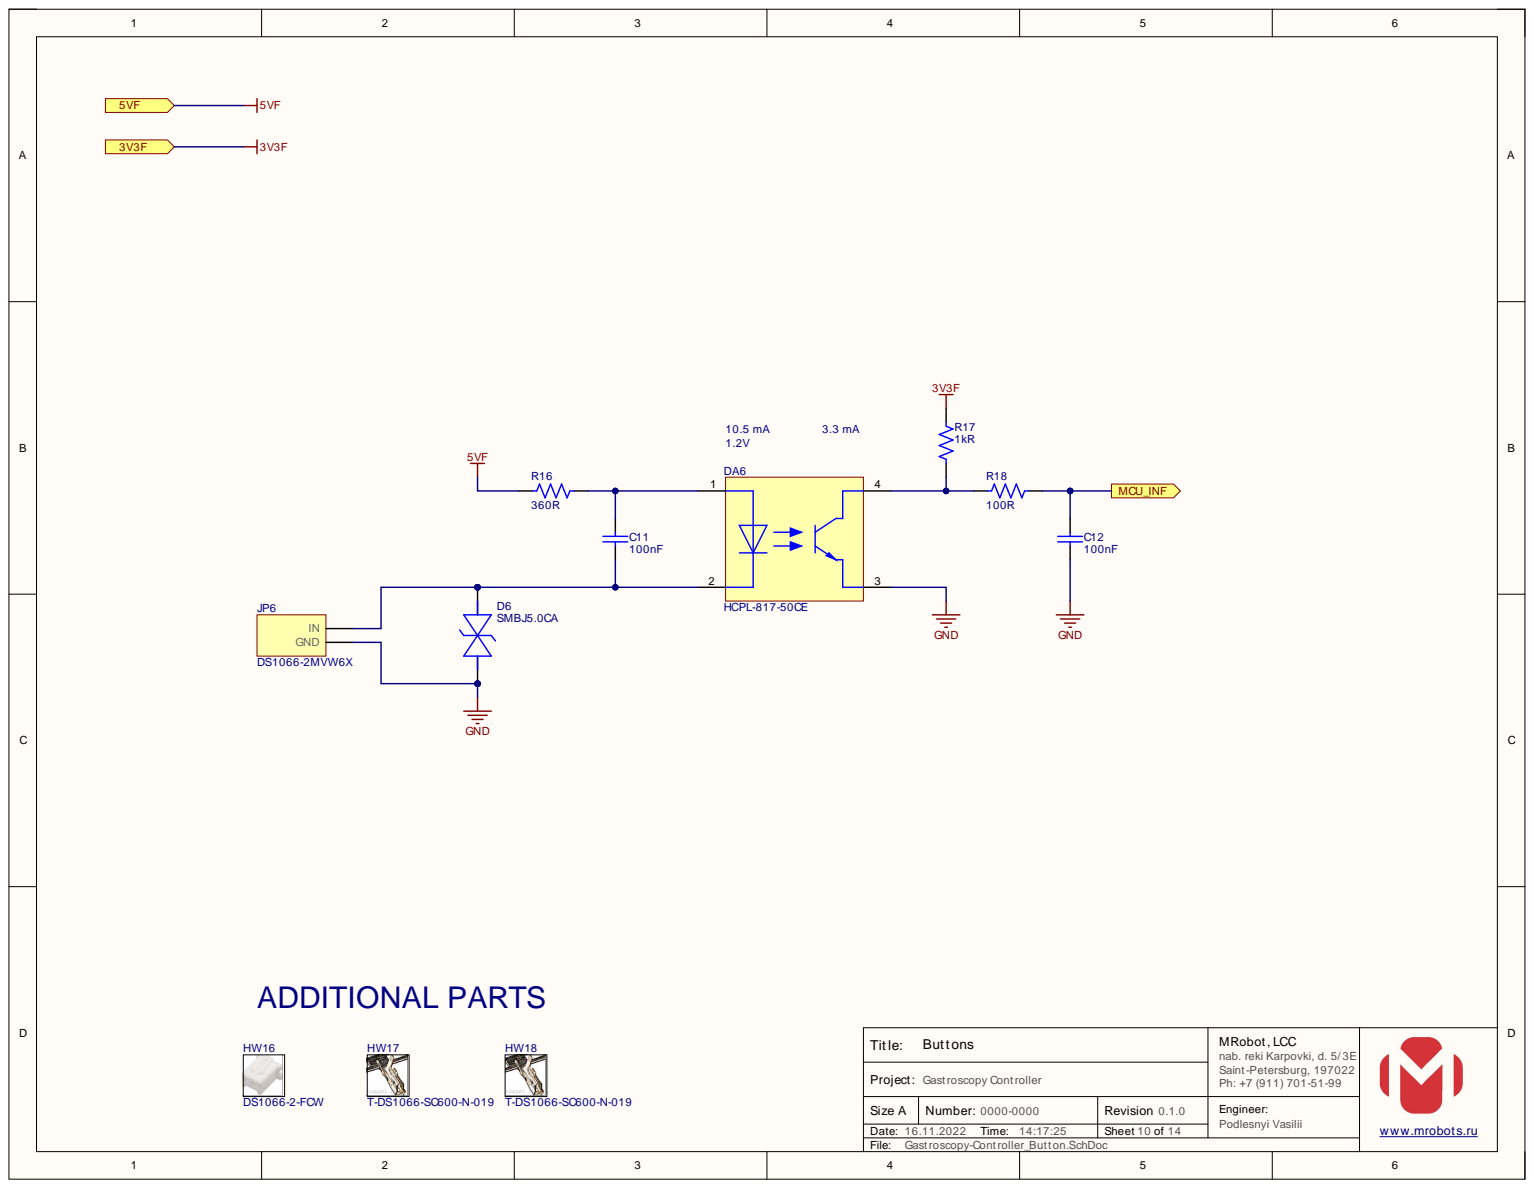
[picture p22: page 10]

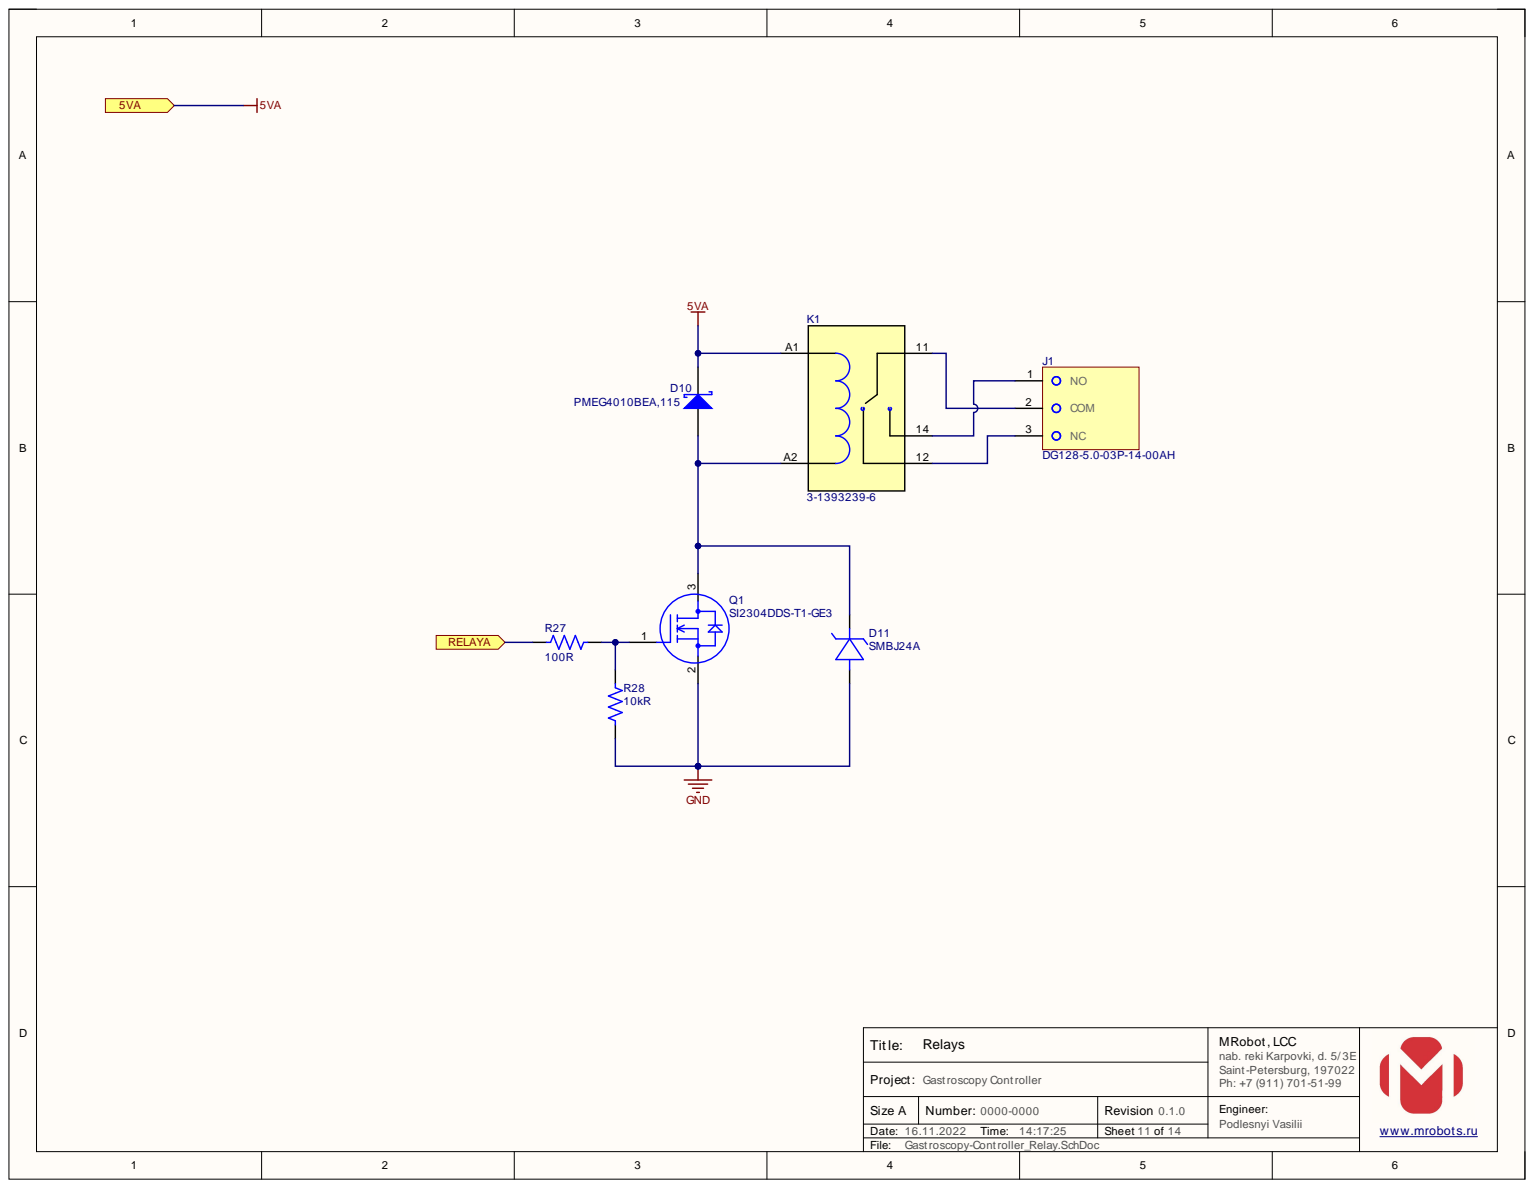
[picture p23: page 11]

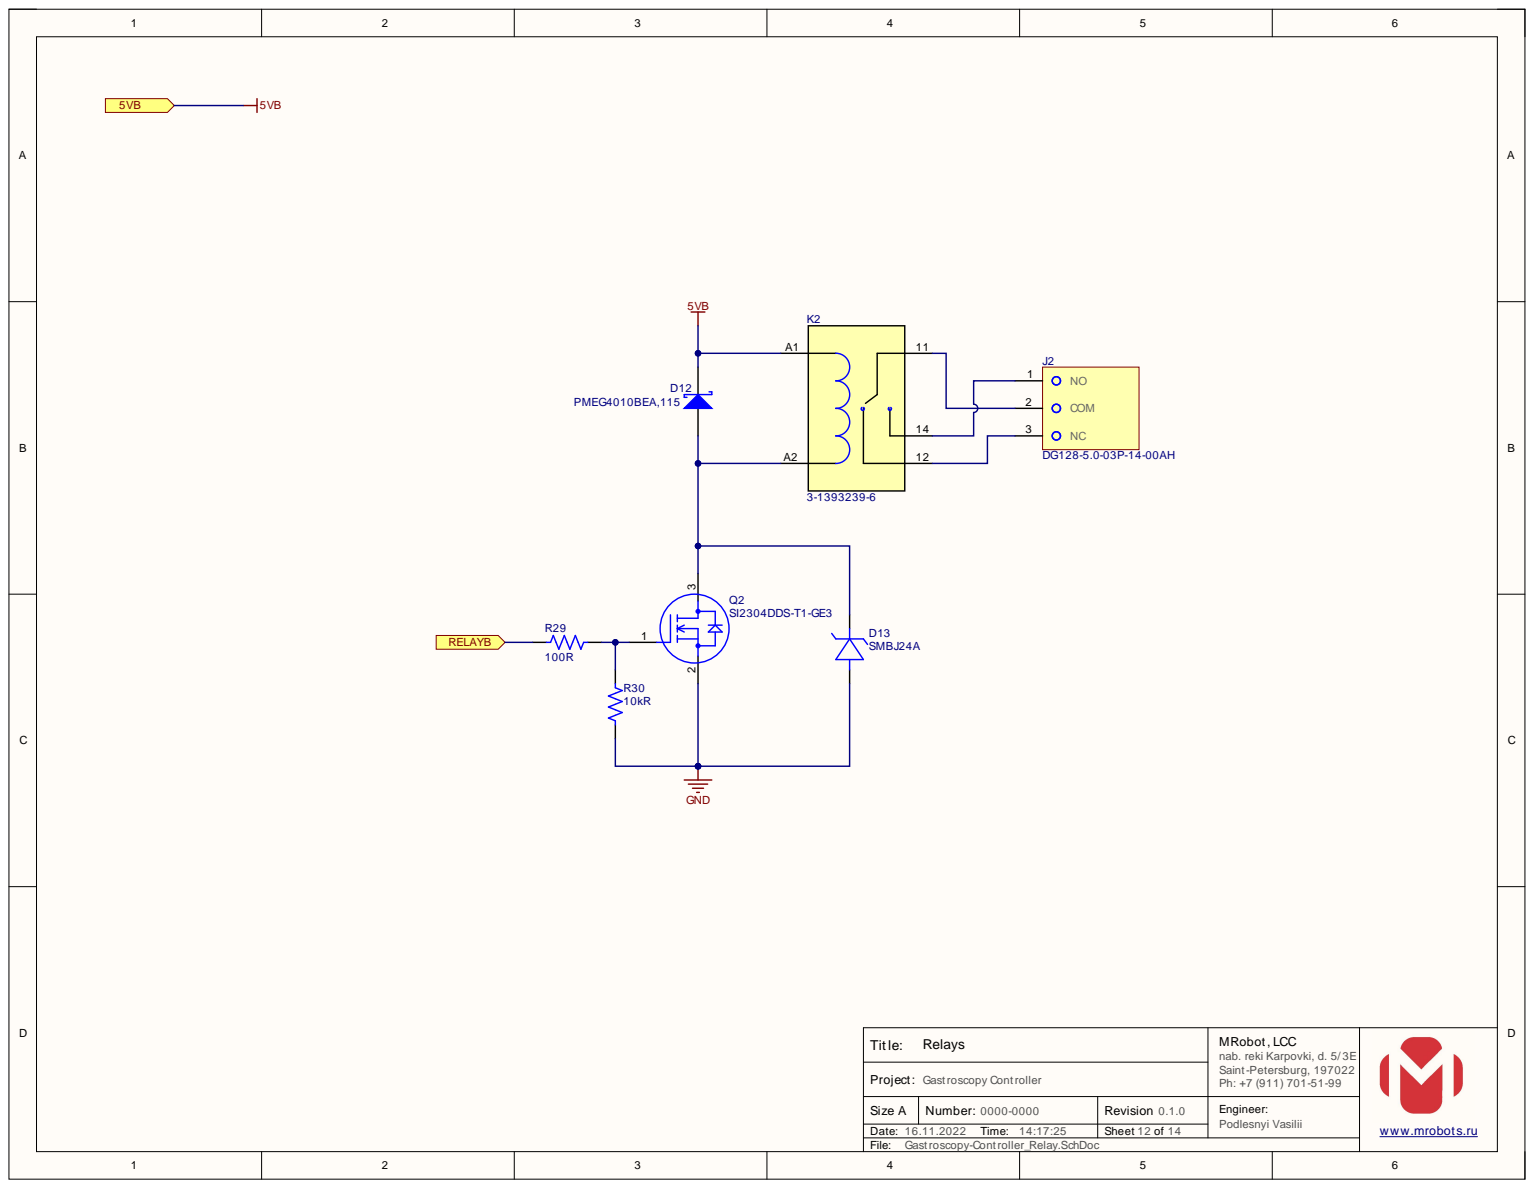
[picture p24: page 12]

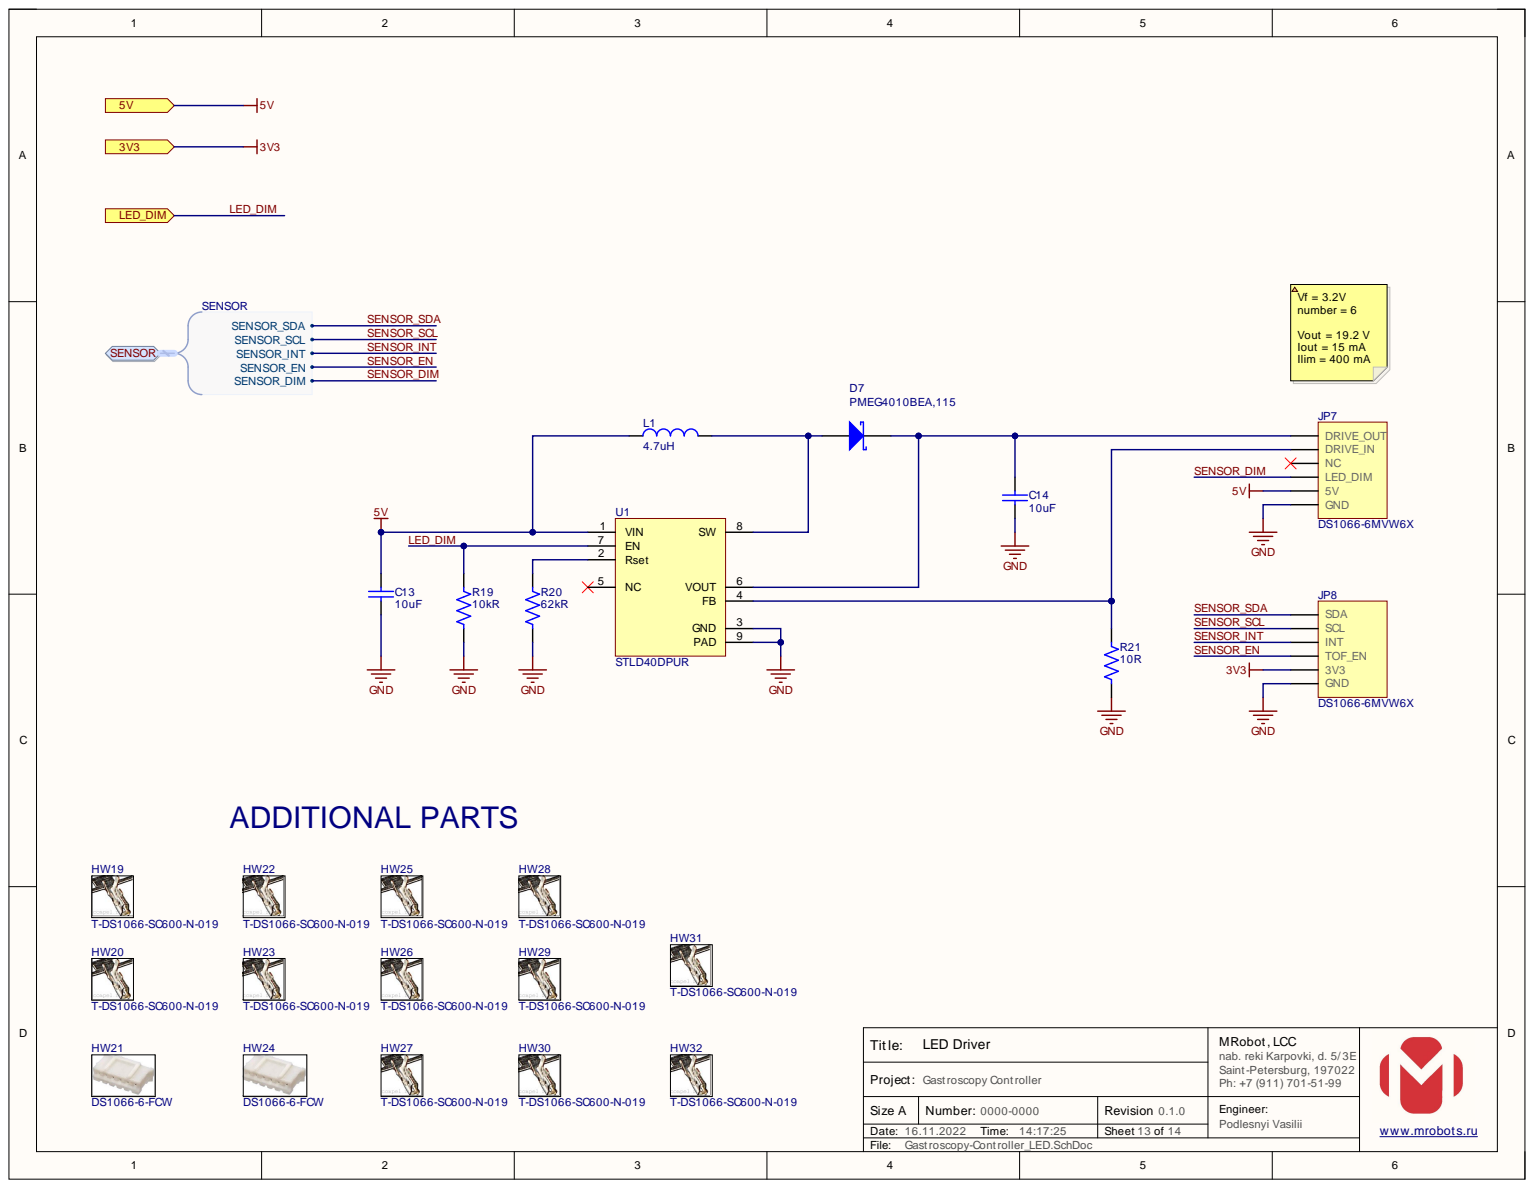
[picture p25: page 13]

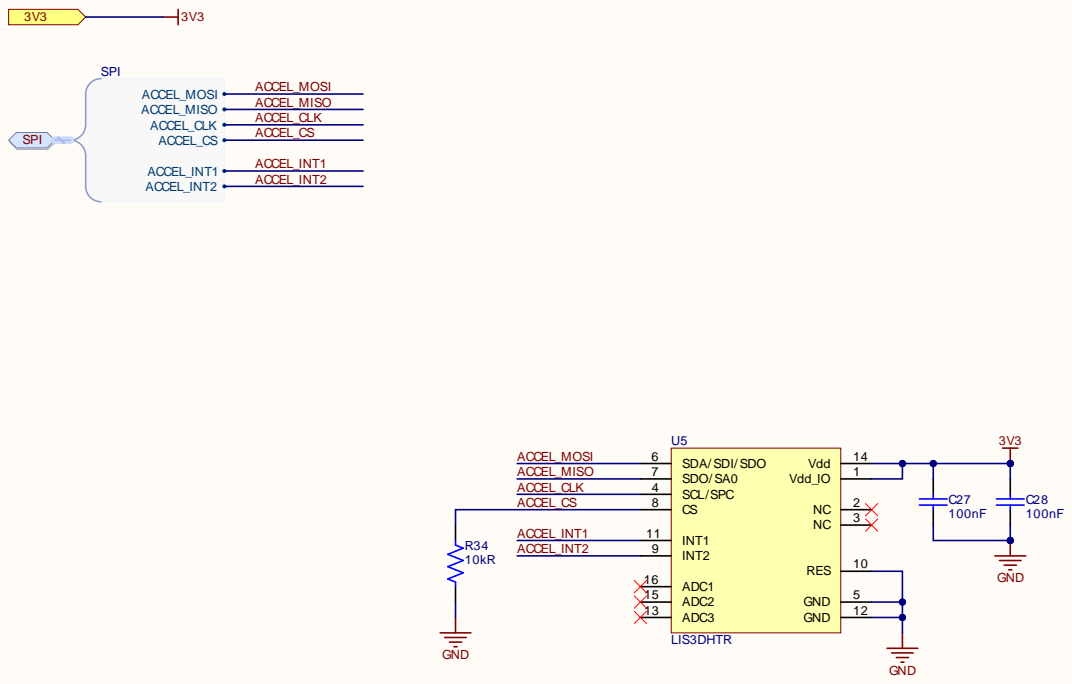
[picture p26: page 14]

S ize A | N u m ber : - | Rev i s i o n 0.1.0 | E n g i neer : Po d les n y i Vas i l i i

Dat e : 6.1 1.2 T i m e : 4:1 7:2 | | S heet o f
