vpodlesnyi/Gastroscopy-Controller/(list of files, drawings)

Other design files:
Gastroscopy-Controller.PrjPcb
SCH/Gastroscopy-Controller_Accelerometer.SchDoc
SCH/Gastroscopy-Controller_Button.SchDoc
SCH/Gastroscopy-Controller_LED.SchDoc
SCH/Gastroscopy-Controller_MCU.SchDoc
SCH/Gastroscopy-Controller_Overview.SchDoc
SCH/Gastroscopy-Controller_Relay.SchDoc
SCH/Gastroscopy-Controller_Title.SchDoc
SCH/Gastroscopy-Controller_USB.SchDoc
