vpodlesnyi/Gastroscopy-Controller/(commit log)

2022-11-09 Created the project. Initially completed schematic design.
    [Estimation-Gastroscopy-Controller.xlsx, Gastroscopy-Controller.PrjPcb, Gastroscopy-Controller_Button.SchDoc, Gastroscopy-Controller_LED.SchDoc, Gastroscopy-Controller_MCU.SchDoc, Gastroscopy-Controller_MPU6500.SchDoc, Gastroscopy-Controller_Overview.SchDoc, Gastroscopy-Controller_Relay.SchDoc]
2022-11-09 Imported schematic design to the PCB.
    [Gastroscopy-Controller.PrjPcb]
2022-11-09 Clear libraries.
    [Gastroscopy-Controller_Button.SchDoc, Gastroscopy-Controller_LED.SchDoc, Gastroscopy-Controller_MCU.SchDoc, Gastroscopy-Controller_Overview.SchDoc, Gastroscopy-Controller_Relay.SchDoc, Gastroscopy-Controller_USB.SchDoc]
2022-11-09 Completed the schematic design.
    [Gastroscopy-Controller.PrjPcb, Gastroscopy-Controller_Button.SchDoc, Gastroscopy-Controller_LED.SchDoc, Gastroscopy-Controller_MCU.SchDoc, Gastroscopy-Controller_Relay.SchDoc, Gastroscopy-Controller_USB.SchDoc]
2022-11-10 Added an accelerometer. Placed components on the PCB.
    [Gastroscopy-Controller.PrjPcb, Gastroscopy-Controller_Accelerometer.SchDoc, Gastroscopy-Controller_MCU.SchDoc, Gastroscopy-Controller_MPU6500.SchDoc, Gastroscopy-Controller_Overview.SchDoc]
2022-11-11 Rechecked libraries. Generated a BOM file.
    [Gastroscopy-Controller.PrjPcb, Gastroscopy-Controller_BOM_Rev_0.1.0_No Variations.xlsx, Gastroscopy-Controller_MCU.SchDoc, Gastroscopy-Tool-Sensor_BOM_Rev_0.1.0_No Variations.xlsx]
2022-11-11 Placed the buttons net.
2022-11-11 Traced polygons under the button's net.
2022-11-11 Placed and traced relay nets.
2022-11-11 Traced an accelerometer.
2022-11-11 Placed and traced joystick USB connection.
2022-11-11 Added the input TVS-diode. Regenerated BOM and SCH files.
    [Gastroscopy-Controller_BOM_Rev_0.1.0_No Variations.xlsx, Gastroscopy-Controller_USB.SchDoc]
2022-11-11 Imported files with a new TVS-diode on the PCB.
    [Gastroscopy-Controller.PrjPcb, Gastroscopy-Controller_Button.SchDoc, Gastroscopy-Controller_LED.SchDoc, Gastroscopy-Controller_MCU.SchDoc, Gastroscopy-Controller_Relay.SchDoc]
2022-11-11 Traced input nets.
2022-11-11 Traced the accelerometer's net.
2022-11-11 Traced the LED driver net.
    [Gastroscopy-Controller_MCU.SchDoc]
2022-11-11 Traced some MCU nets.
    [Gastroscopy-Controller_MCU.SchDoc]
2022-11-12 Completed tracing PCB.
    [Gastroscopy-Controller.PrjPcb, Gastroscopy-Controller_MCU.SchDoc]
2022-11-14 ---> Release v0.1.0
    [Gastroscopy-Controller.PrjPcb, Gastroscopy-Controller_Button.SchDoc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]
2022-11-16 Сhanged the Main MCU.
    [Gastroscopy-Controller.PrjPcb, Gastroscopy-Controller_BOM_Rev_0.1.0_No Variations.xlsx, Gastroscopy-Controller_MCU.SchDoc]
